vladubase/Linelance/Scheme/Linelance/Project Outputs for Linelance/3Dview/3Dview_3.jpg

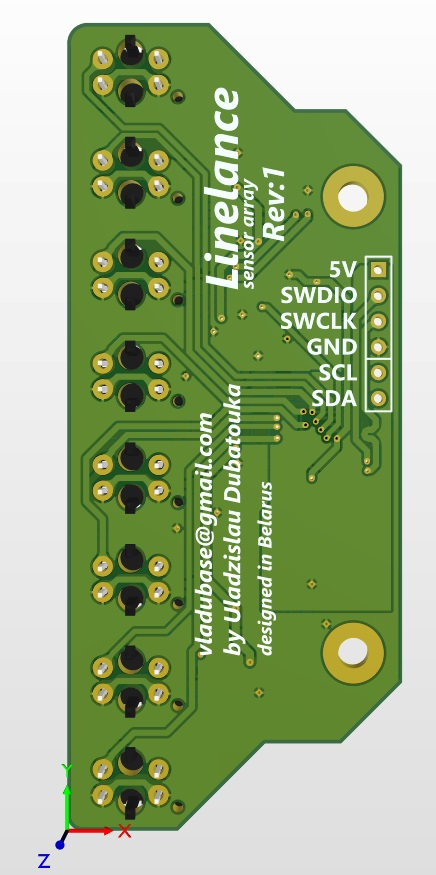
Scheme/Linelance/Project Outputs for Linelance/3Dview/3Dview_3.jpg
