vladubase/Linelance/Scheme/Linelance/Project Outputs for Linelance/3Dview/3Dview_2.jpg

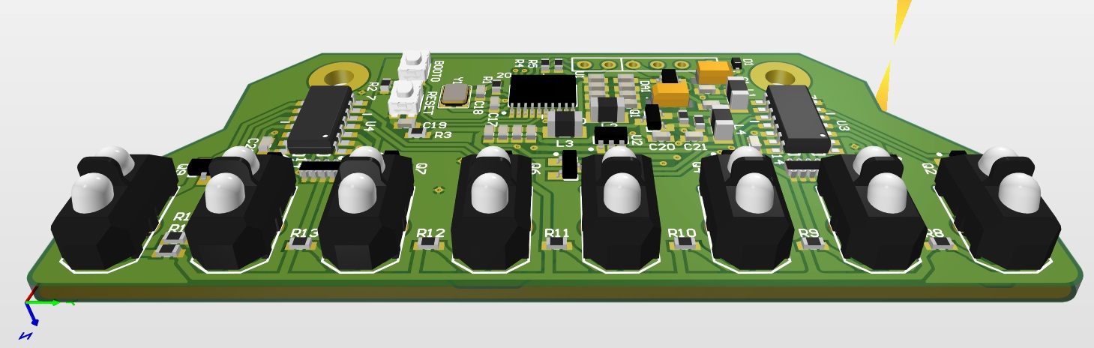
Scheme/Linelance/Project Outputs for Linelance/3Dview/3Dview_2.jpg
