vladubase/Linelance/README.md

# Linelance
IR Module based on 8 reflective object sensors TCRT5000. Use microcontroller STM32F030 for receiving data from sensors via a parallel interface, it is possible to adjust the reference voltage on the optocoupler transistors via PWM.
