vladubase/Linelance/Scheme/Linelance/Project Outputs for Linelance/3Dview/3Dview_1.jpg

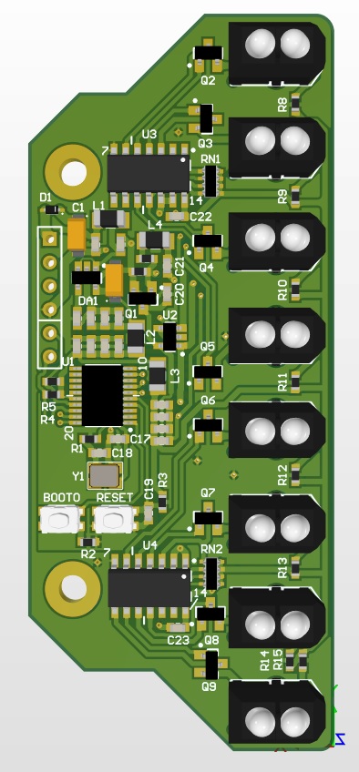
Scheme/Linelance/Project Outputs for Linelance/3Dview/3Dview_1.jpg
