vladubase/Linelance/Scheme/STM32F030F4P6_pinout.bmp

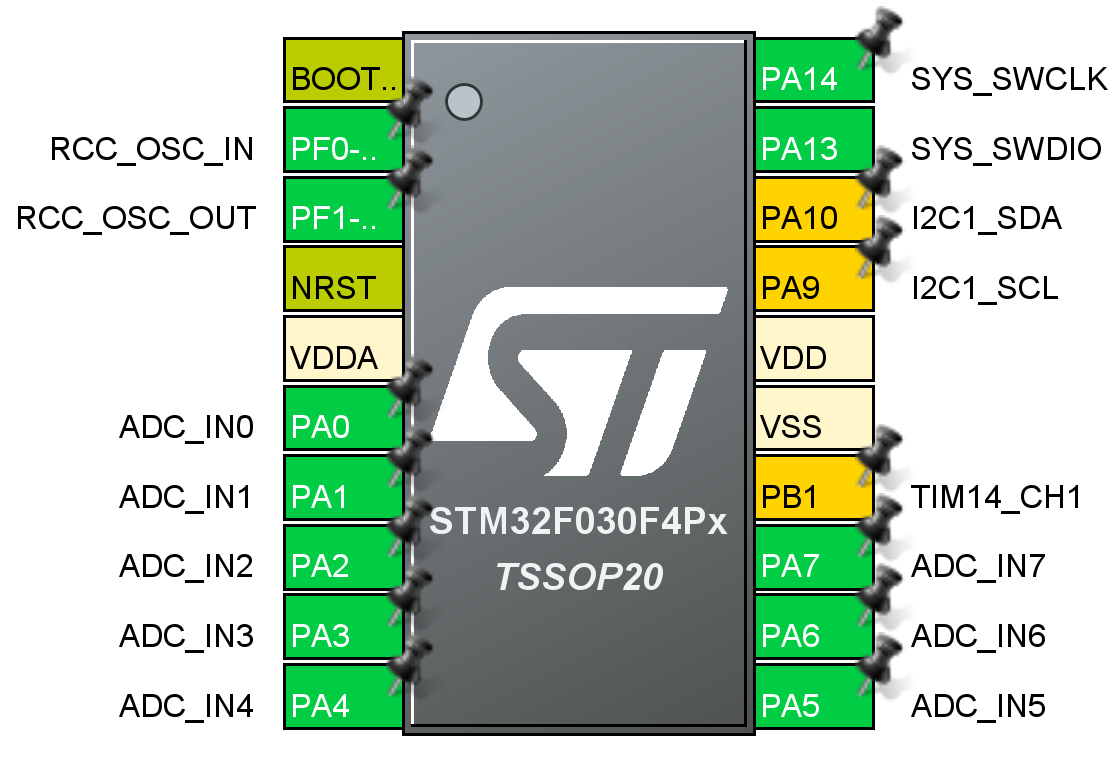
Scheme/STM32F030F4P6_pinout.bmp
