vladubase/Linelance/Scheme/Linelance/Linelance_PCB.step

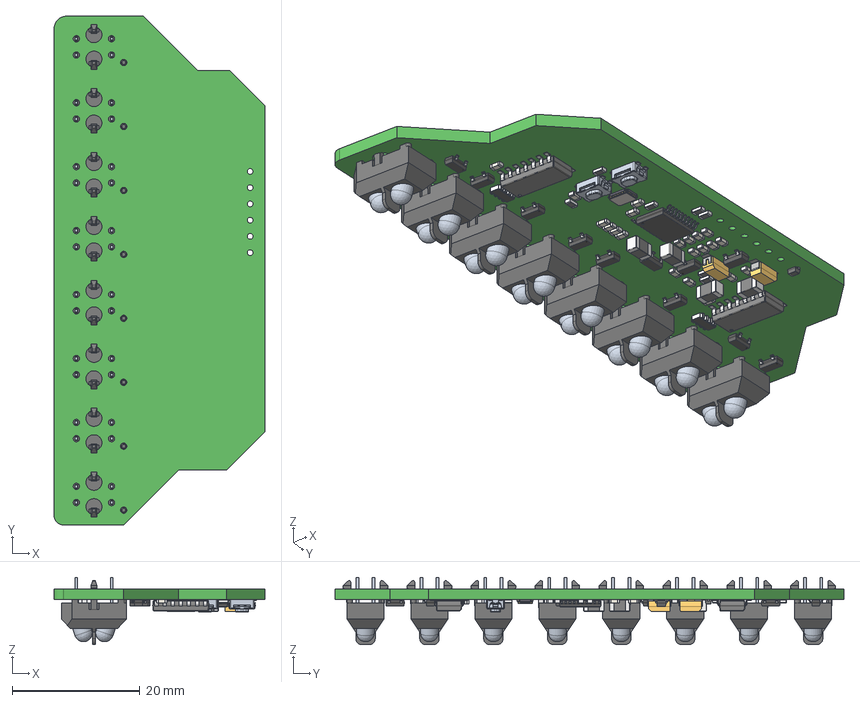
[picture p5: CAD file, 2020-10-01]
Scheme/Linelance/Linelance_PCB.step
33.0 x 79.6 x 10.5 mm
Extruded x 63
Mid_Body x 15
Open_CASCADE_STEP_translator_6.8_7.2.1 x 30
Mark x 15
TSX-3225
Open_CASCADE_STEP_translator_6.8_25.1.1 x 2
mark x 2
Open_CASCADE_STEP_translator_6.8_25.3.1 x 16
SOT23-3 x 9
LEDs x 8
Metal_Contacts x 8
SOT23-5 x 2
TANT-A x 2
Open_CASCADE_STEP_translator_6.8_12.1 x 2
Open_CASCADE_STEP_translator_6.8_12.2.1 x 2
Leader x 28
TSSOP-20
KMR221GLFS x 2
Open_CASCADE_STEP_translator_6.8_9.1.1 x 4
Open_CASCADE_STEP_translator_6.8_9.1.2 x 4
Open_CASCADE_STEP_translator_6.8_9.2.1 x 4
SOD523
