vladubase/Linelance/Scheme/Linelance/Project Outputs for Linelance/Linelance_OutDocs.PDF

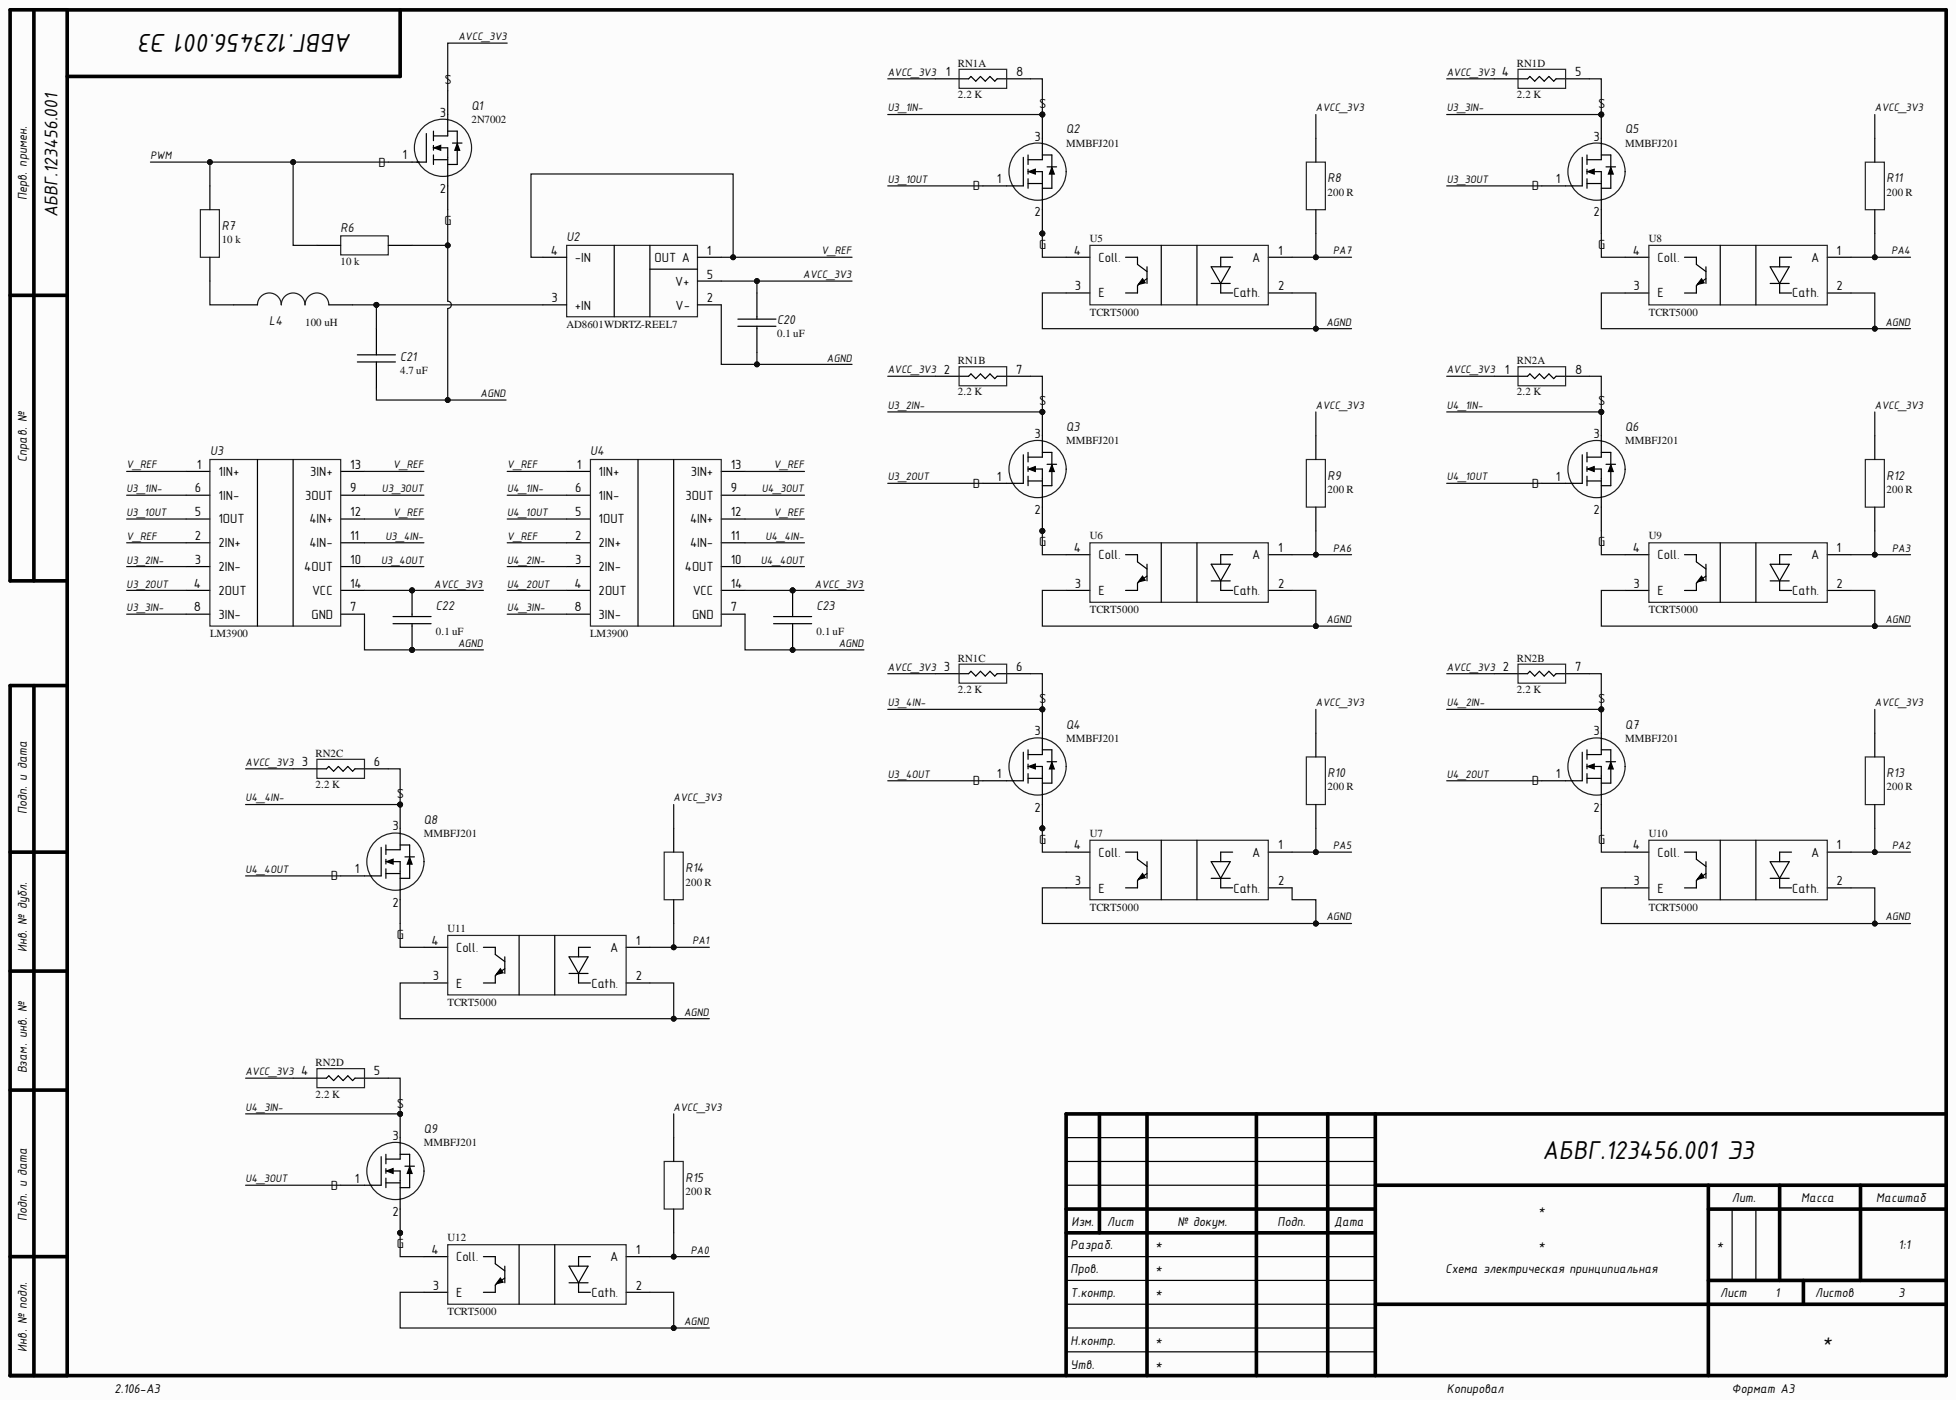
[picture p6: page 1]

Инв. № подл. Инв. № дубл. Подп. и дата Взам. инв. № Подп. и дата Перв. примен. Справ. №

АБВГ.123456.001 Э 3

* * Схем а электрическа я принципиальна я | Лит . | Масса | Масшта б

. Лист Р азра б . | | *

Изм . | | № докум . | Подп . | Да т а | | * | | | 1: 1

Пров . | | *

Т .контр | * | | | | Лист | Листов

Н .контр . | *

Утв . | *

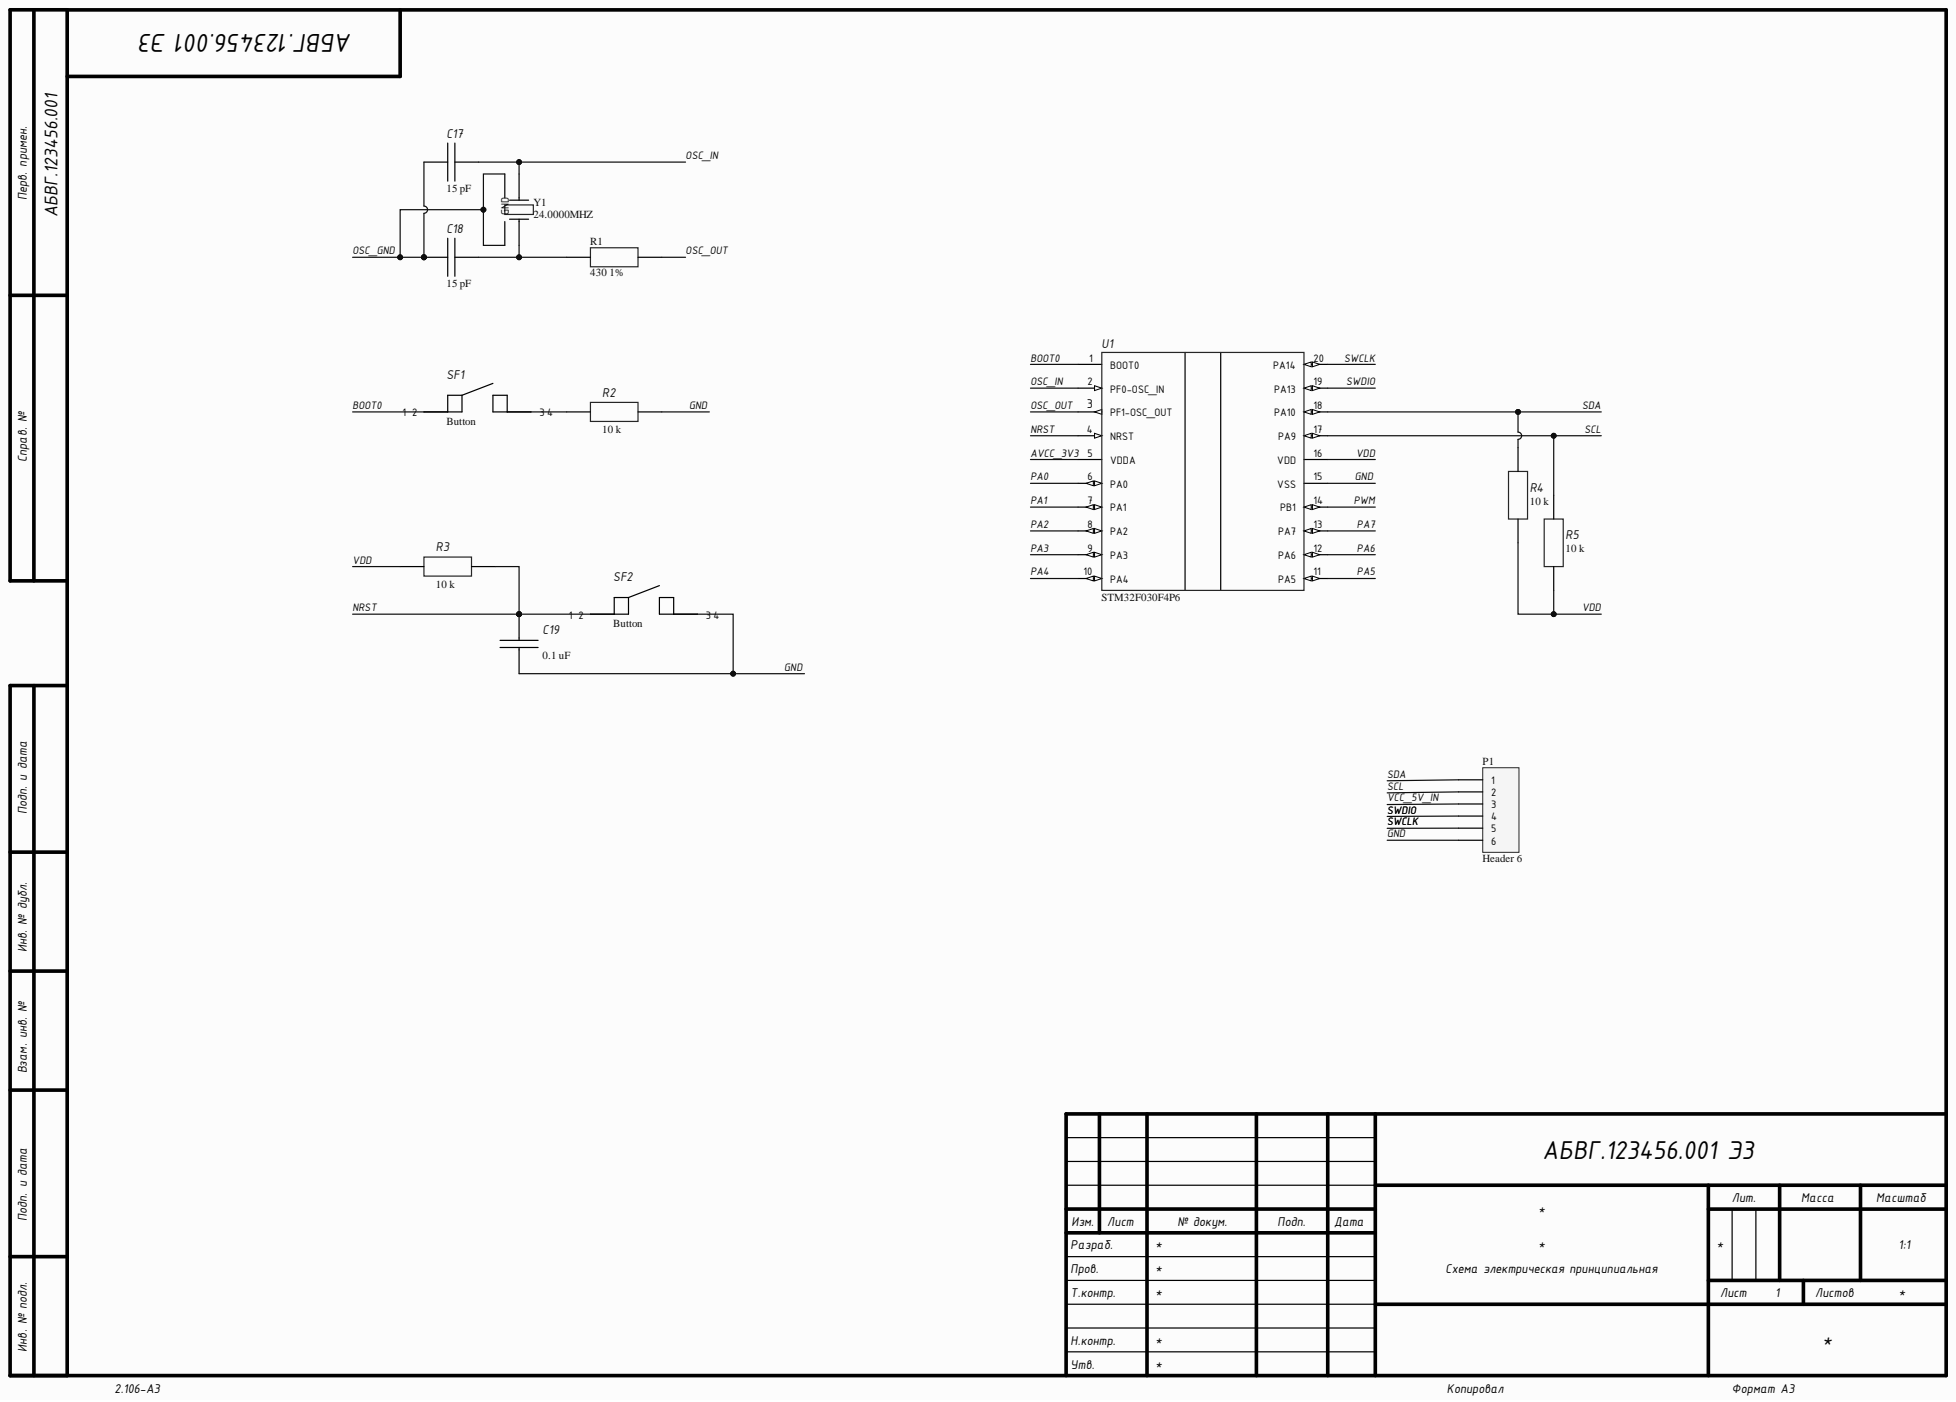
[picture p7: page 2]

Инв. № подл. Инв. № дубл. Подп. и дата Взам. инв. № Подп. и дата Перв. примен. Справ. №

BOOT0 PF0-OSC_I N PF1-OSC_OUT NRST VDDA PA0 PA1 PA2 PA3 PA4 | PA1 PA1 3 PA1 0 PA9 VDD VSS PB1 PA7 PA6

АБВГ.123456.001 Э 3

* * Схем а электрическа я принципиальна я | Лит . | Масса | Масшта б

. Лист Р азра б . | | *

Изм . | | № докум . | Подп . | Да т а | | * | | | 1: 1

Пров . | | *

Т .контр | * | | | | Лист | Листов *

Н .контр . | *

Утв . | *

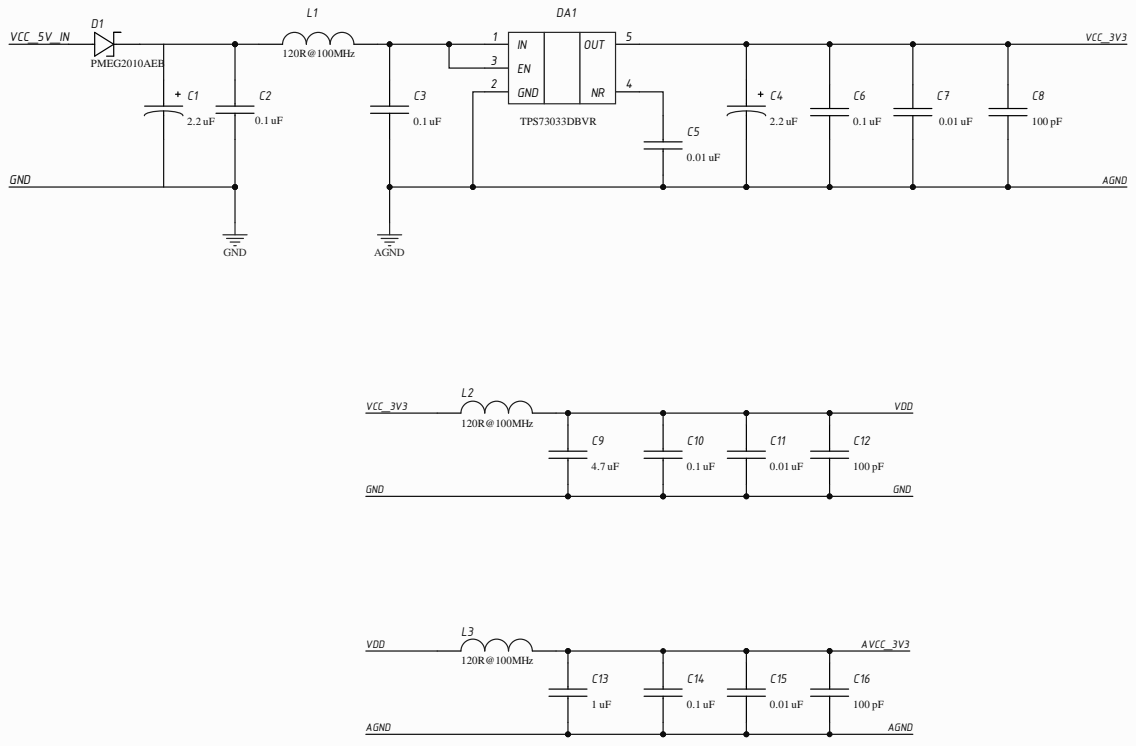
[picture p8: page 3]

Инв. № подл. Инв. № дубл. Подп. и дата Взам. инв. № Подп. и дата Перв. примен. Справ. №

Лит. | Масса | Масштаб

Изм. | Лист | № докум. | Подп. | Дата | | | | | 1:1

Разраб. | | Дубатовка В.В.

Пров.

Т.контр. | | | | | Лист | Листов 3

Н.контр.

Утв.
