vladubase/Linelance/(list of files, drawings)

Other design files:
Scheme/Linelance/Linelance.PrjPcb
Scheme/Linelance/Linelance_PCB.PcbDoc
Scheme/Linelance/Linelance_Schematic_page1.SchDoc
Scheme/Linelance/Linelance_Schematic_page2.SchDoc
Scheme/Linelance/Linelance_Schematic_page3.SchDoc
