vladubase/Linelance/(commit log)

2020-10-01 Add: Scheme of Linelance rev.1.
    [Linelance.PrjPcb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]
2020-10-01 Add: STM32F030 pinout scheme.
2020-10-01 Add: STM32F030 RCC scheme.
2020-10-01 Replace files for ordering boards in production.
2020-10-01 Replace files about STM32F030 schematic.
2020-10-01 Add: STM32F030 security Application Note.
2020-11-08 Change connections of PA7..0 of TCRT5000 sensors. Was absolutely wrong
    [Linelance_PCB v1.1.PcbDoc, Linelance_PCB v1.2.PcbDoc, Linelance_Schematic_page3.SchDoc]
2020-11-08 Change PCB according trace fix PA7..0.
    [Linelance_PCB v1.2.PcbDoc]
2020-11-08 Update project. Add PCB ver1.2.
    [Linelance.PrjPcb]
2020-11-08 Change connections of PA7..0 of TCRT5000 sensors. Was absolutely wrong.
    [Linelance_Schematic_page3.SchDoc]
2021-02-14 Change folder structure.
    [Linelance.PrjPcb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]
2021-02-14 Modify Sheet's formatting
    [Linelance.PrjPcb, Linelance_PCB.PcbDoc, Linelance_Schematic_page1.SchDoc, Linelance_Schematic_page2.SchDoc, Linelance_Schematic_page3.SchDoc]
2021-02-14 Edit schematics of some parts.
2021-02-14 Change button schematic.
2021-02-14 Update components from library.
    [Linelance.PrjPcb, Linelance_Schematic_page1.SchDoc, Linelance_Schematic_page2.SchDoc, Linelance_Schematic_page3.SchDoc]
2021-02-14 Add: For capacitors parameter 'Voltage'.
2021-02-14 Update all components; Add more specific description.
    [Linelance_Schematic_page1.SchDoc]
2021-02-14 Update all components; Add more specific description of components; Add zones on sheet for better readability.
    [Linelance_Schematic_page2.SchDoc]
2021-02-14 Add zones on sheet for better readability; Add Notes on sheet.
    [Linelance_Schematic_page1.SchDoc]
2021-02-14 Update info about L1
    [Linelance_Schematic_page1.SchDoc]
2021-02-14 Update schematic of AD8601.
2021-02-14 Update schematic of LM3900D
2021-02-14 Modify structure of sheets; Update schematics of all components;
    [Linelance.PrjPcb, Linelance_PCB.PcbDoc, Linelance_Schematic_page1.SchDoc, Linelance_Schematic_page2.SchDoc, Linelance_Schematic_page3.SchDoc]
2021-02-14 Edit N-CH MOSFET toP-CH; Update description of a component.
2021-02-16 Edit parametres of some components
    [Linelance_Schematic_page2.SchDoc]
2021-02-16 Update look of header P1.
    [Linelance_Schematic_page2.SchDoc]
2021-02-16 Update designators of capacitors C4..8: change order.
    [Linelance_Schematic_page1.SchDoc]
